SunDevilRocketry/Flight-Computer-R3/Flight-Computer/Flight-Computer.step

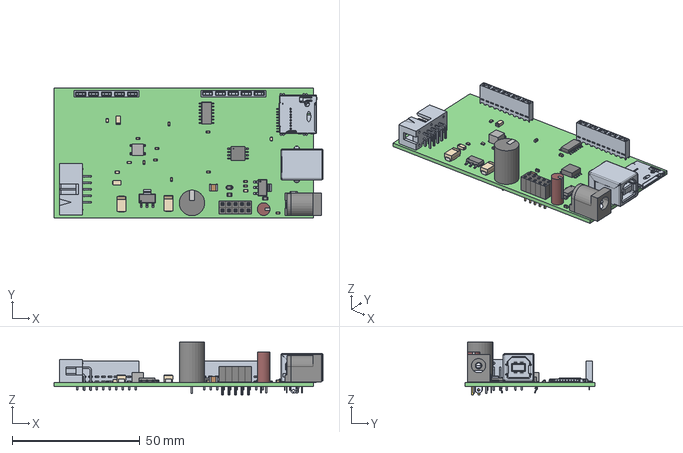
[picture p1: CAD file, 2025-02-21]
Flight-Computer/Flight-Computer.step
105.4 x 50.8 x 20.6 mm
