SunDevilRocketry/Flight-Computer-R3/(threads)

Thread 1 (2025-01-12):

Design a prototype with STM32WBA chip

niekky, 2025-01-12:
Design a foundation PCB that satisfies all features brought from Flight Computer Rev 2 and supports BLE technologies.

Thread 2 (2025-01-24):

Design Pressure Transducer reader

niekky, 2025-01-24:
Design a PT reader electronics placed on the flight computer pcb.

Here are basic requirements (still subject to change):
- Support at least 2 PTs
- Require at least ADC channel (one ADC is ideal)

Thread 3 (2025-01-24):

Design a load cell

niekky, 2025-01-24:
Add load cell into Flight Computer R3 PCB

Requirements:
- Use at most 1 ADC for reading
- Use op amp/amplifier to amplify to readable voltage (the standard is 5V)

Thread 4 (2025-01-24):

Design a power meter

niekky, 2025-01-24:
Add a power meter to the Flight Computer R3 for measuring power supply's fundamental electrical properties

dmortloff, 2025-03-28:
Research and add power meters to board in order to debug and see potential power anomalies

Thread 6 (2025-02-14):

Add a secondary Flash module

niekky, 2025-02-14:
As a requirement, the rev3 shall have a secondary flash memory so that it can store configuration/preset data without affecting the primary flash memory that's mainly for flight data storage.

Chip requirements:
- The chip needs to be interfaced through SPI
- The chip shall be powered by 3.3V
- The chip doesn't need to have memory as big as the main flash memory. (Configuration data is small and is not stored repetitively)
- The chip should be smaller than the main flash memory in terms of size.

dmortloff, 2025-02-26:
Added 2nd Microchip Technology Flash (SST25VF512A-33-4I-SAE) instead of previous flash
Added ground to UART connector, and 4xed schematic
New Flash can be found here
https://www.digikey.com/en/products/detail/microchip-technology/SST25VF512A-33-4I-SAE/2299415
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

niekky, 2025-02-26:
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

Looks nice but here are some minor things:
- You're using European (not US) resistor symbol, Could you change it to the US symbol?

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

- 10k label should be enough instead of "10kOhm"

For UART, could you rotate and have the Earth symbols pointing downward?

Closed 2025-02-28.

Thread 7 (2025-02-14):

Add an UART terminal

niekky, 2025-02-14:
As requirements, the rev3 shall have an UART terminal port so that it can connect and wire communicate with other SDR boards.

Requirements:
- The port shall have a 5V power rail
- The port shall only have UART TX and RX wires for communication

dmortloff, 2025-02-21:
Repurposed 440054 Schematic and footprint (previous use servo PWM connection terminals) to develop new UART port
Features 5V, TX and RX starting with labels PUART to indicate peripheral UART

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

dmortloff, 2025-02-26:
4xed UART connectors with additional pin, and added GND tab on bottom

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

Closed 2025-02-28.

Thread 8 (2025-02-26):

Upgrade IMU units

niekky, 2025-02-26:
We should start looking into IMU upgrade since BMI323 is becoming obsolete soon and is range limited. It is recommended to have more than one IMU so that Flight Computer could do sensor fusion and combine data which allows bias elimination and more robustness.

Here is a potential set of IMU:
- BMI323 (primary imu)
- ADXL375 (Accelerometer dedicated to measuring high g, supports up to 200g)
- MC3419 (light IMU to measure below 8g with high sensitivity LSB/g)

KeeganF1yNN, 2025-09-18:
300g good sensitivity

Thread 9 (2025-02-26):

Design a PCB prototype with STM32WBA and antenna to test bluetooth capability

niekky, 2025-02-26:

fallencoffee, 2025-03-05:
Files are in Bluetooth breakout folder in Github

dmortloff, 2025-03-25:
Designed basic testing board with selected components (see BBB repo)

Thread 10 (2025-03-01):

Replace Buck Converter with Low dropout Regulator

niekky, 2025-03-01:

dmortloff, 2025-03-03:
Changed Buck to new 3.3-1.8V LDO
MIC5365-1.8YC5-TR
https://www.digikey.com/en/products/detail/microchip-technology/MIC5365-1-8YC5-TR/1868082

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

Thread 12 (2025-03-24):

Add external UART ports to board layout

dmortloff, 2025-03-24:
Free spaces on the board have been located from .ioc STMCubeIDE file, UART ports will be added from those ports

1. Change KiCad Schematic to match pinouts
2. Decide on footprints for new additions
3. Wire new ports to MCU (Requires Expanding Board)

Closed 2025-10-01.

Thread 13 (2025-03-24):

Change MicroUSB to USBC

dmortloff, 2025-03-24:
Change the MicroUSB port on the flight computer to a USBC Connector

fallencoffee, 2025-03-27:
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

fallencoffee, 2025-03-27:
added USB-C
unknown on where to put configuration channel(CC) to
SBU is put to ground since it is mainly for video data transmission

fallencoffee, 2025-03-27:
may need to change the second D+ and D- pinouts

dmortloff, 2025-03-28:
Which branch is this on perchance?

fallencoffee, 2025-03-29:
it should be branched off in USB-C

dmortloff, 2025-10-01:
Marking as done af Rev3 (2.5) is now finished

Thread 15 (2025-03-28):

Part Reinventory

dmortloff, 2025-03-28:
The Flight Computer takes a solid chunk out of our budget. Cheaper parts would improve board reusability

This is more of a general task, look for cheaper components and replace them when possible

Thread 18 (2025-09-17):

Research ThermoCouple

dmortloff, 2025-09-17:
AHPR also wants thermocouple support for the board. As this is a relatively new addition for us, heavy support is required.

Research thermocouples and how they transmit data, as well as how we can transmit this data onto a PCB

dmortloff, 2025-10-01:
Marking as done as we didn't actually need a thermocouple on the board

Closed 2025-10-01.

Thread 19 (2025-09-18):

Research STM32

dmortloff, 2025-09-18:
Were running out of space on our MCU. We need one that has more pins, hopefully cheaper, and hopefully faster

Abridgmo, 2025-09-19:
Current Micro Controller: STM32H750VBT6
-Issues: Not enough pins, slow

Upgrade Option 1: STM32H750IBK6
-140 I(nput)/O(output) pins > 82 pins
-!!! Price: $11.74 > $10.09
-Same on everything else

Option 2: STM32H725IGK6
-128 I/O pins > 82
-550MHz speed > 480MHz
-!!! Price: $13.89 > $10.09
-!!! Ram Size: 564KB < 1MB
-!!! 12-12bit channels & 22-16bit channels A(nalog to)/D(igital) < 36-16bit channels

Option 3: STM32H725AGI6
-121 I/O pins > 82
-550MHz > 480MHz
-Memory Size: 1MB >> 128KB
-!! Price: $10.99 > $10.09
-!!! Ram Size: 564KB < 1MB
-!!! 12-12bit channels & 22-16bit channels A/D < 36-16bit channels

Option 4: STM32H730IBK6Q
-128 I/O pins > 82 pins
-550MHz > 480MHz
-Price: $9.73 < $10.09
-!!! Ram Size: 564KB < 1MB
-!!! 12-12bit channels & 22-16bit channels A/D < 36-16bit channels

-4 might be the best if you want a cheaper chip at faster speed. The only trade offs are less resolution on some of the A/D channels (also 2 less channels), and halving the RAM size.
-My search parameters on Digikey were:
-Microcontrollers
-Mounting Type: Surface Mount
-Speed: Anything at or above 480MHz
-# of I/0: Anything at or above 82
-Core Size: 32 bit
-Product Status: Active
-Packaging: Tray
-Memory Type: FLASH
-Oscillator Type: Internal
