SunDevilRocketry/Flight-Computer-R3/(commit log)

2025-02-21 PUART and PFlash
    Added Peripheral board UART and Preset Flash
    [Connectors.kicad_sch, Connectors.sch, Flash_SD.kicad_sch, Flash_SD.sch, Flight-Computer.kicad_pcb, Flight-Computer.kicad_sch, Flight-Computer.sch, Flight-Computer.step]
2025-02-26 New Flash/4x UART
    Added Microchip Technologies Flash and 3 more UART peripheral connectors
    [Flight-Computer.kicad_sch, Rev3.kicad_sch, peripherals.kicad_sch, sensors.kicad_sch]
2025-03-03 American PFLASH/PUART
    Made to appease the American mind (Changed symbols and orientations)
    [Flight-Computer.kicad_sch, Rev3.kicad_sch, peripherals.kicad_sch, sensors.kicad_sch]
2025-03-03 LDO update
    Changed buck 1.8V converter to LDO
    [Flight-Computer.kicad_pcb, sensors.kicad_sch]
2025-03-28 Ports
    Added 2 UART ports for connectivity, expanded board
    [Flight-Computer.kicad_pcb, Flight-Computer.kicad_sch, Rev3.kicad_sch, peripherals.kicad_sch]
2025-09-23 most up to date rev 2.5 files
    third connector (where micro sd used to be) does not have tx3 pins connected (pin outs needed in order to wire)
    [Flight-Computer.kicad_pcb, Flight-Computer.kicad_sch, Rev3.kicad_sch, peripherals.kicad_sch]
